StudioKAT/GateSequencer/README.md

# Gate Sequencer
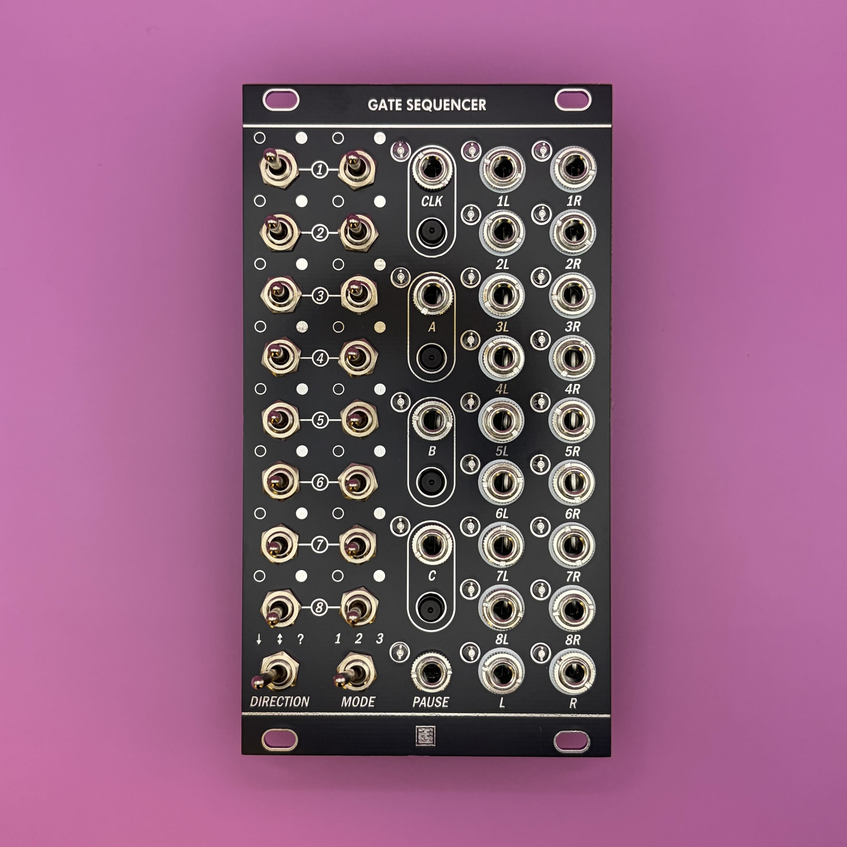
[picture p1: v2.0/Images/GateSequencer_v2.0_Front.jpg]
Gate Sequencer Front


## 概要 / Overview

**Gate Sequencer** は、トグルスイッチ式の多機能ゲートシーケンサーです。   
・独立した2つのクロックで動く **8 Stepシーケンサー x2**  
・パフォーマンス機能を備えた **16 Stepシーケンサー**  
・可変長・経路変更可能な **シフトレジスタ (Turing Machine)**  
の3つの機能を備え、スイッチ一つで切り替えて使用できます。

**Gate Sequencer** is a multi-functional gate sequencer equipped with toggle switches. It features three distinct functions that can be switched via a single mode switch:
* **8-Step Sequencer x2** running on independent clocks.
* **16-Step Sequencer** with performance features.
* **Shift Register (Turing Machine)** with variable length and routing capabilities. 

## 仕様 / Spec
- Format: Eurorack
- Function: Gate Sequencer
- Current needs: +12V: 50mA, -12V: 0mA
- Width: 14 HP
- Depth: 25mm (including power connector)

## 販売 / Sales

StudioKATオフィシャルショップで販売しています。(日本国内限定)  
https://www.studiokat.jp/items/164466252

## ライセンス / License

この作品は [Creative Commons 表示 - 継承 4.0 国際 (CC BY-SA 4.0)](https://creativecommons.org/licenses/by-sa/4.0/deed.ja) の下でライセンスされています。  
This work is licensed under the [Creative Commons Attribution-ShareAlike 4.0 International License](https://creativecommons.org/licenses/by-sa/4.0/).

## クレジット / Credits

- Designed by : StudioKAT
- Website : https://www.studiokat.jp/
- GitHub : https://github.com/StudioKAT
- X(Twitter) : https://x.com/StudioKAT_synth
- Instagram : https://www.instagram.com/studiokat_modular/

## 更新履歴 / Changelog

- `2026-10-29`：v2.0 リリース
- `2025-11-22`：v1.0 リリース
