StudioKAT/GateSequencer/Images/GateSequencer_v1.0_Back.jpg

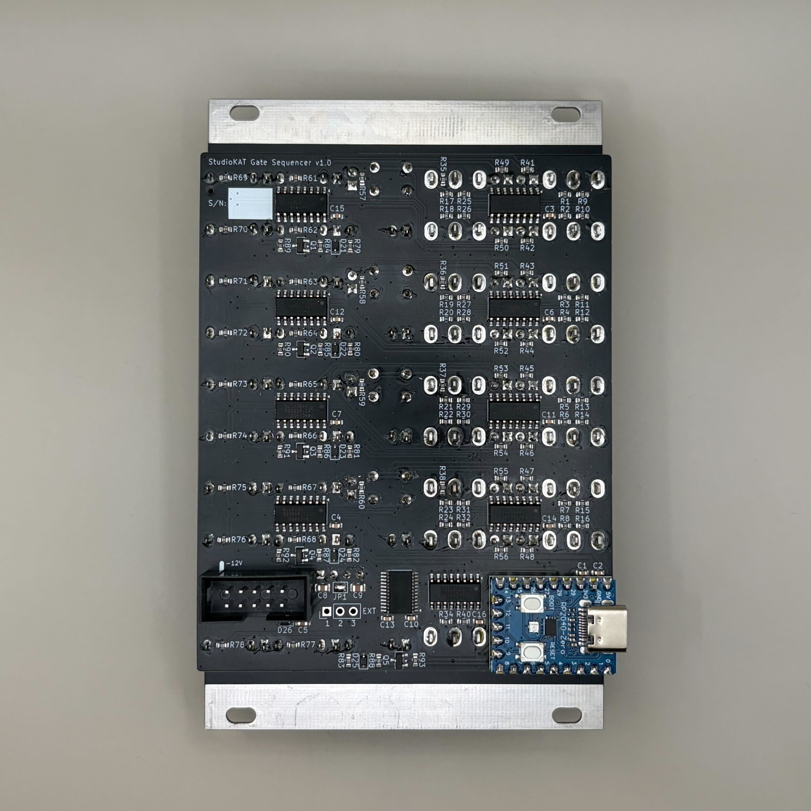
Images/GateSequencer_v1.0_Back.jpg
