StudioKAT/GateSequencer/v2.0/Images/GateSequencer_v2.0_Back.jpg

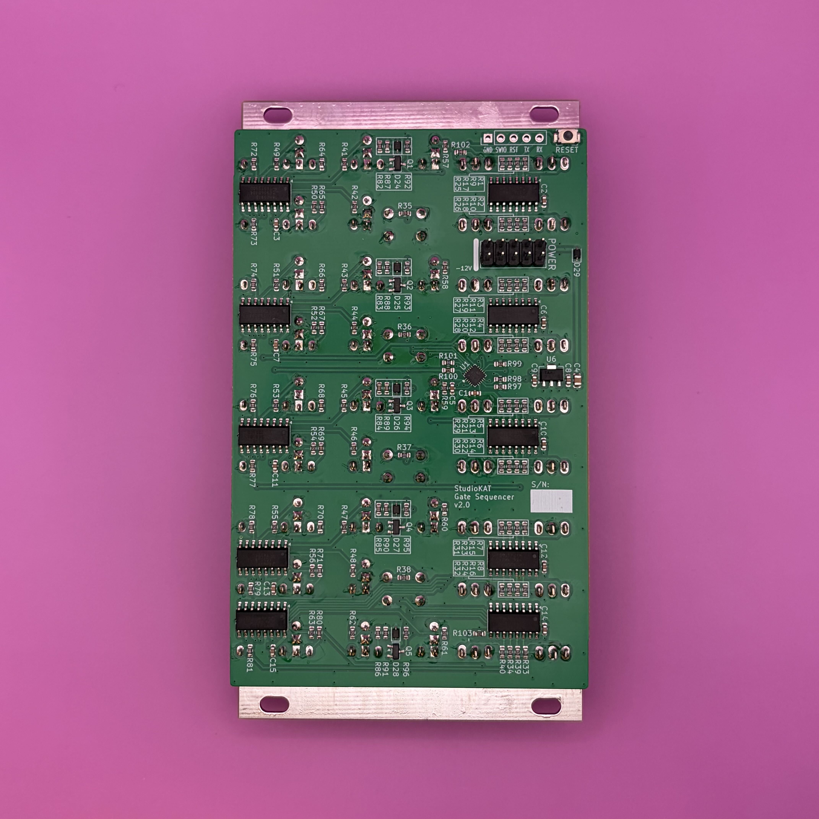
v2.0/Images/GateSequencer_v2.0_Back.jpg
