StudioKAT/GateSequencer/v2.0/Hardware/Gerber_for_JLCPCB/Main/bom.csv

Designator | Footprint | Quantity | Value | LCSC Part #
C1, C10, C11, C12, C13, C14, C15, C2, C3, C5, C6, C7, C9 | 0603 | 13 | 100nF | C14663
C4 | 0805 | 1 | 22uF | C45783
C8 | 0603 | 1 | 330nF | C1615
D1, D10, D11, D12, D13, D14, D15, D16, D17, D18, D19, D2, D20, D21, D22, D23, D3, D4, D5, D6, D7, D8, D9 | LED_D3.0mm_2hp | 23 | LED
D24, D25, D26, D27, D28 | D_SOD-323 | 5 | 1N4148WS | C2128
D29 | D_SOD-323 | 1 | 1N5819WS | C64886
J1 | AudioJack_PJ301M-12 | 1 | OUT_1
J10 | AudioJack_PJ301M-12 | 1 | OUT_10
J11 | AudioJack_PJ301M-12 | 1 | OUT_11
J12 | AudioJack_PJ301M-12 | 1 | OUT_12
J13 | AudioJack_PJ301M-12 | 1 | OUT_13
J14 | AudioJack_PJ301M-12 | 1 | OUT_14
J15 | AudioJack_PJ301M-12 | 1 | OUT_15
J16 | AudioJack_PJ301M-12 | 1 | OUT_16
J17 | AudioJack_PJ301M-12 | 1 | OUT_A
J18 | AudioJack_PJ301M-12 | 1 | OUT_B
J19 | AudioJack_PJ301M-12 | 1 | CLK
J2 | AudioJack_PJ301M-12 | 1 | OUT_2
J20 | AudioJack_PJ301M-12 | 1 | IN_A
J21 | AudioJack_PJ301M-12 | 1 | IN_B
J22 | AudioJack_PJ301M-12 | 1 | IN_C
J23 | AudioJack_PJ301M-12 | 1 | PAUSE
J24 | PinHeader_2x05_2.54mm_Europower | 1 | POWER
J25 | PinHeader_1x05_P2.54mm_Vertical | 1 | Conn_01x05_Pin
J3 | AudioJack_PJ301M-12 | 1 | OUT_3
J4 | AudioJack_PJ301M-12 | 1 | OUT_4
J5 | AudioJack_PJ301M-12 | 1 | OUT_5
J6 | AudioJack_PJ301M-12 | 1 | OUT_6
J7 | AudioJack_PJ301M-12 | 1 | OUT_7
J8 | AudioJack_PJ301M-12 | 1 | OUT_8
J9 | AudioJack_PJ301M-12 | 1 | OUT_9
Q1, Q2, Q3, Q4, Q5 | SOT-23 | 5 | MMBT3904 | C20526
R1, R10, R11, R12, R13, R14, R15, R16, R17, R18, R19, R2, R20, R21, R22, R23, R24, R25, R26, R27, R28, R29, R3, R30, R31, R32, R33, R34, R35, R36, R37, R38, R39, R4, R40, R5, R6, R7, R8, R9, R92, R93, R94, R95, R96 | 0603 | 45 | 12K | C22790
R100, R103, R97, R98, R99 | 0603 | 5 | 47 | C23182
R101, R102, R64, R65, R66, R67, R68, R69, R70, R71, R72, R73, R74, R75, R76, R77, R78, R79, R80, R81 | 0603 | 20 | 1k | C21190
R41, R42, R43, R44, R45, R46, R47, R48, R49, R50, R51, R52, R53, R54, R55, R56, R57, R58, R59, R60, R61, R62, R63 | 0603 | 23 | 2.4K | C22940
R82, R83, R84, R85, R86, R87, R88, R89, R90, R91 | 0603 | 10 | 100K | C25803
SW1, SW10, SW11, SW12, SW13, SW14, SW15, SW16, SW17, SW18, SW2, SW3, SW4, SW5, SW6, SW7, SW8, SW9 | ToggleSwitch_SMTS-103-2A1 | 18 | SMTS-103-2A1
SW19, SW20, SW21, SW22 | SW_PUSH_6mm_H13mm | 4 | SW_Push
SW23 | SW_Push_TS-1088-AR02016 | 1 | RESET | C720477
U1 | QFN-20-1EP_3x3mm_P0.4mm_EP1.65x1.65mm | 1 | CH32V003F4U6 | C5299908
U10, U12, U3, U5, U8 | SOIC-16_3.9x9.9mm_P1.27mm | 5 | 74HC595D,118 | C5947
U11, U2, U4, U7, U9 | SOIC-16_3.9x9.9mm_P1.27mm | 5 | 74HC165D,653 | C5613
U6 | SOT-89-3 | 1 | 78L05G-AB3-R | C71136
