StudioKAT/GateSequencer/v2.0/Hardware/Schematics/GateSequencer_scheatics_v2.0.pdf

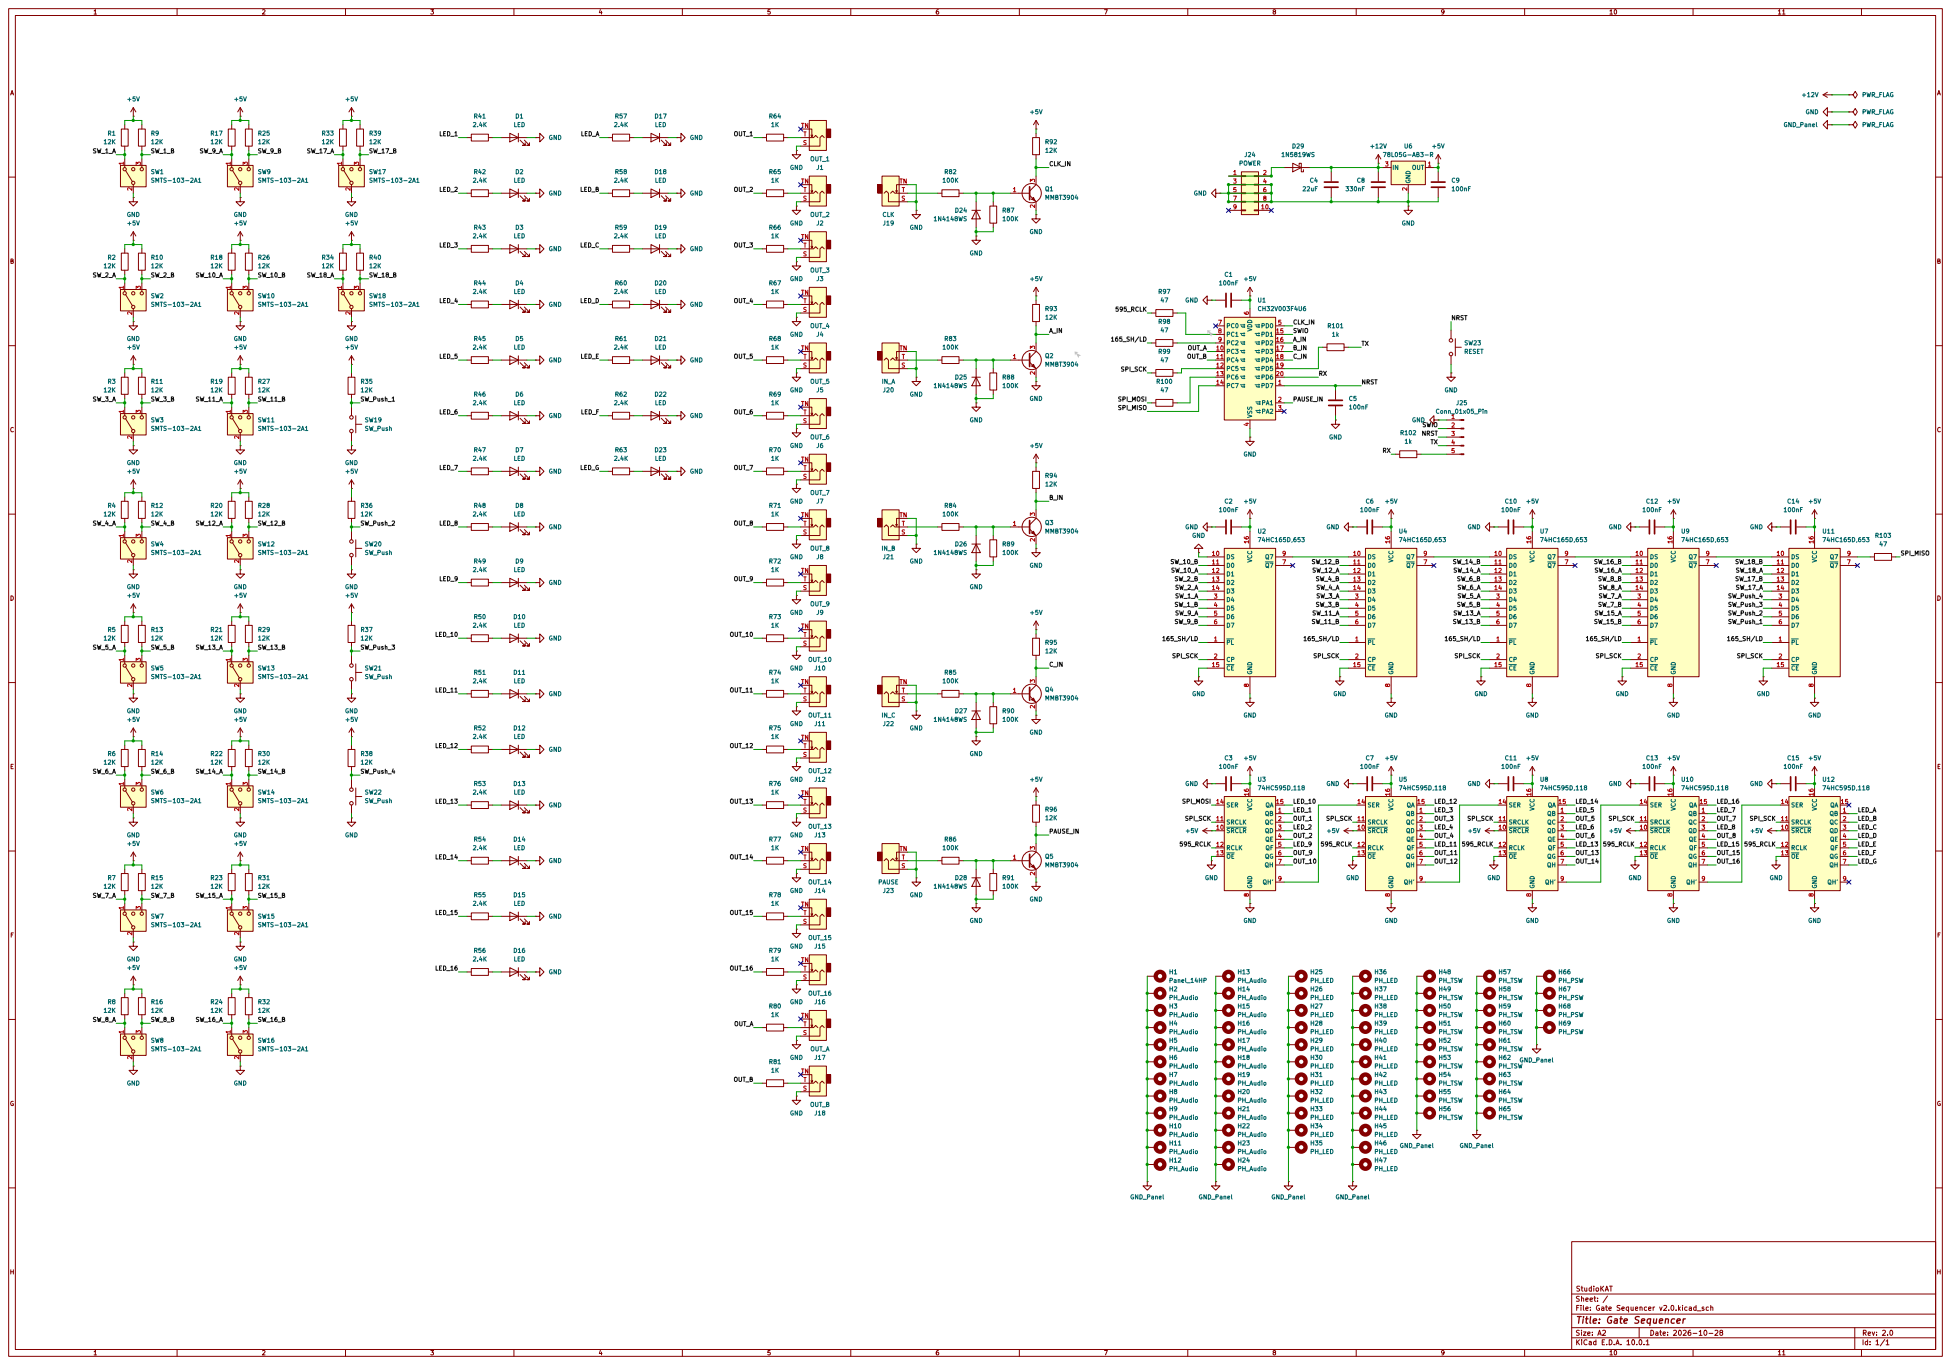
[picture p7: page 1]
