StudioKAT/GateSequencer/v1.0/Hardware/Schematics/GateSequencer_schematics_v1.0.pdf

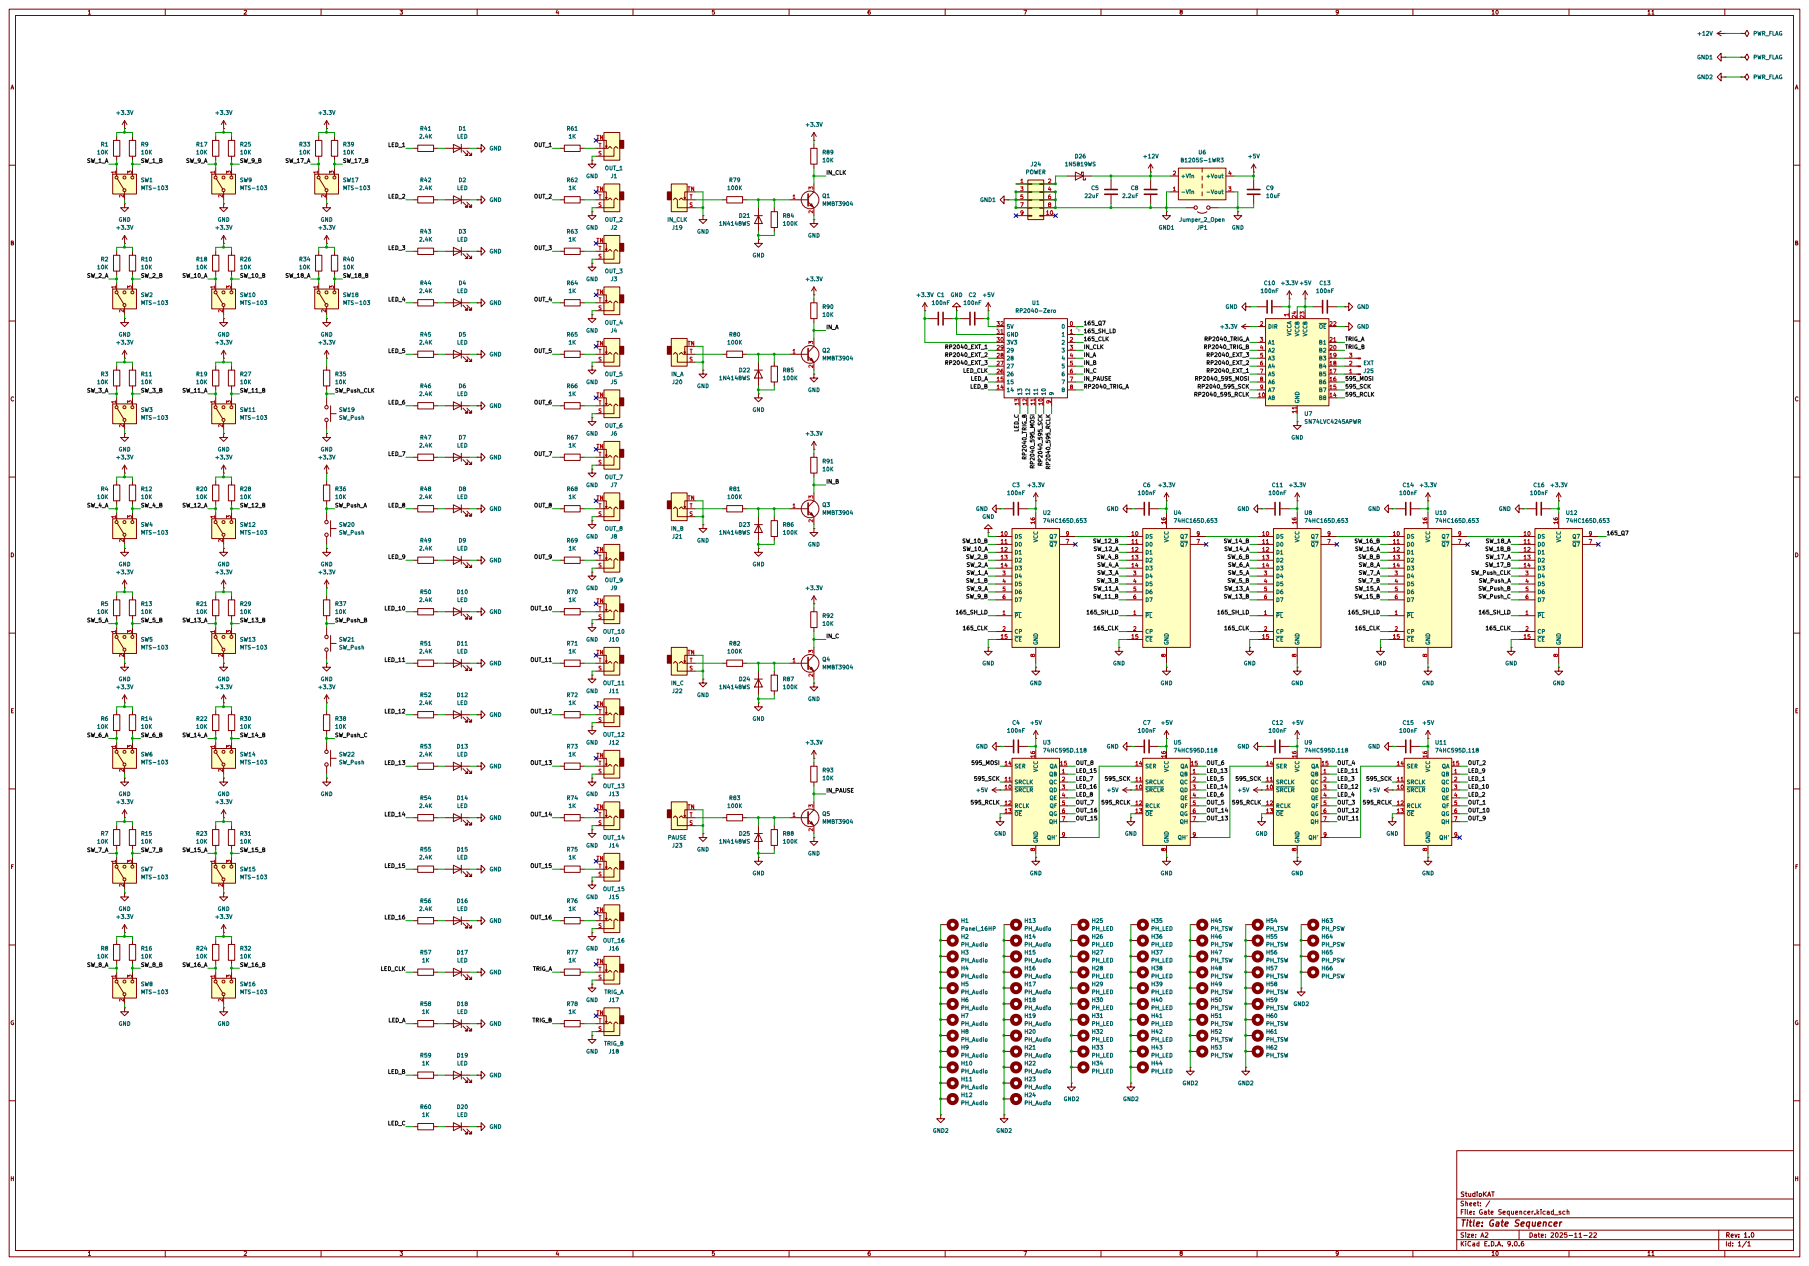
[picture p8: page 1]
