StudioKAT/GateSequencer/v1.0/Hardware/KiCAD/Gate Sequencer/Gate Sequencer.kicad_pcb

## KiCad design v1.0/Hardware/KiCAD/Gate Sequencer/Gate Sequencer.kicad_pcb (2026-10-30, an earlier design)

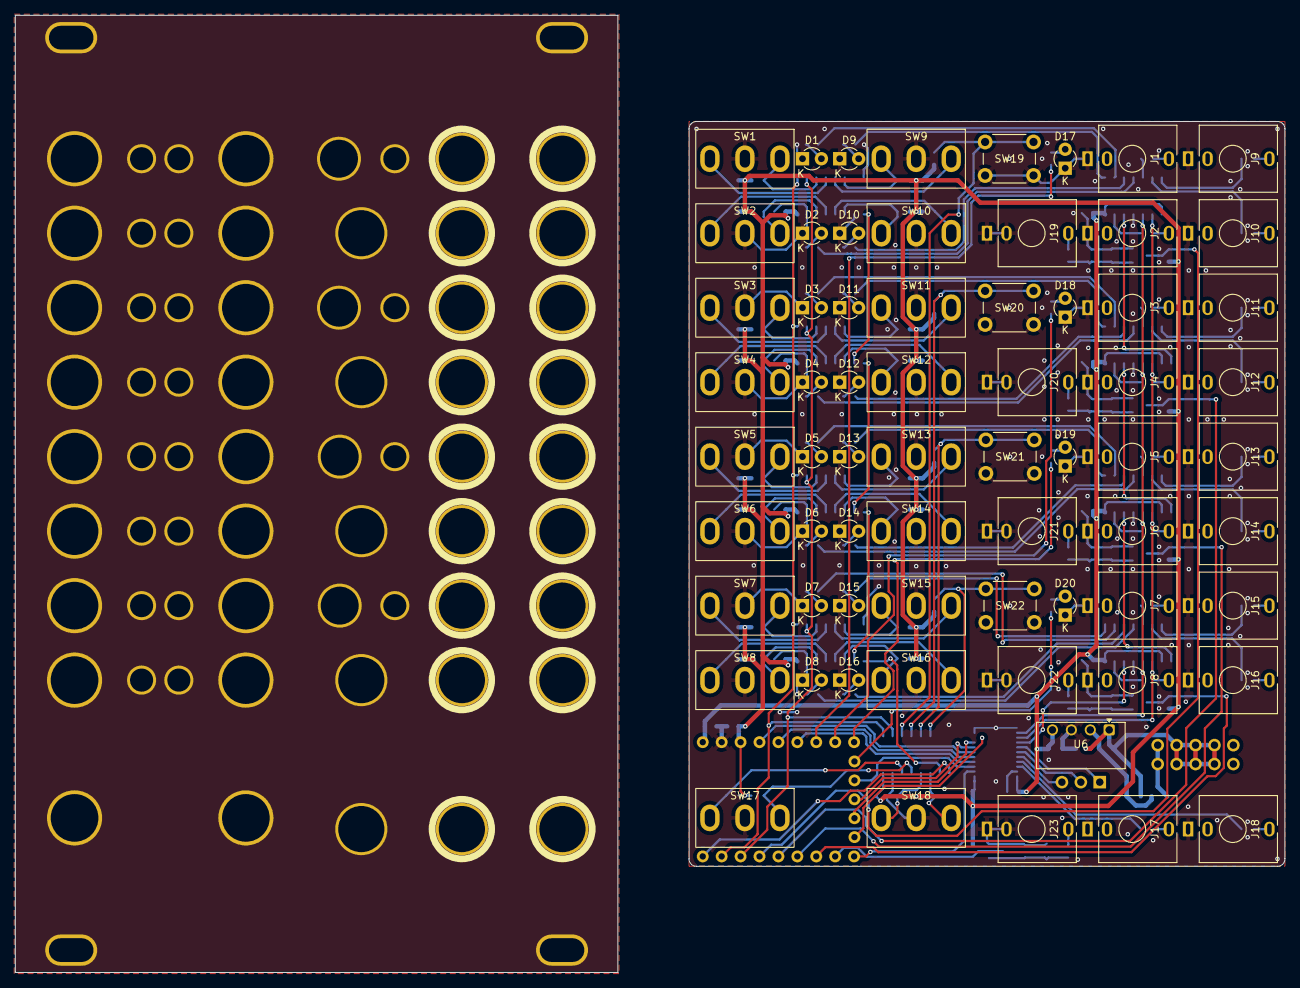
[picture p13: board Gate Sequencer.kicad_pcb from above]

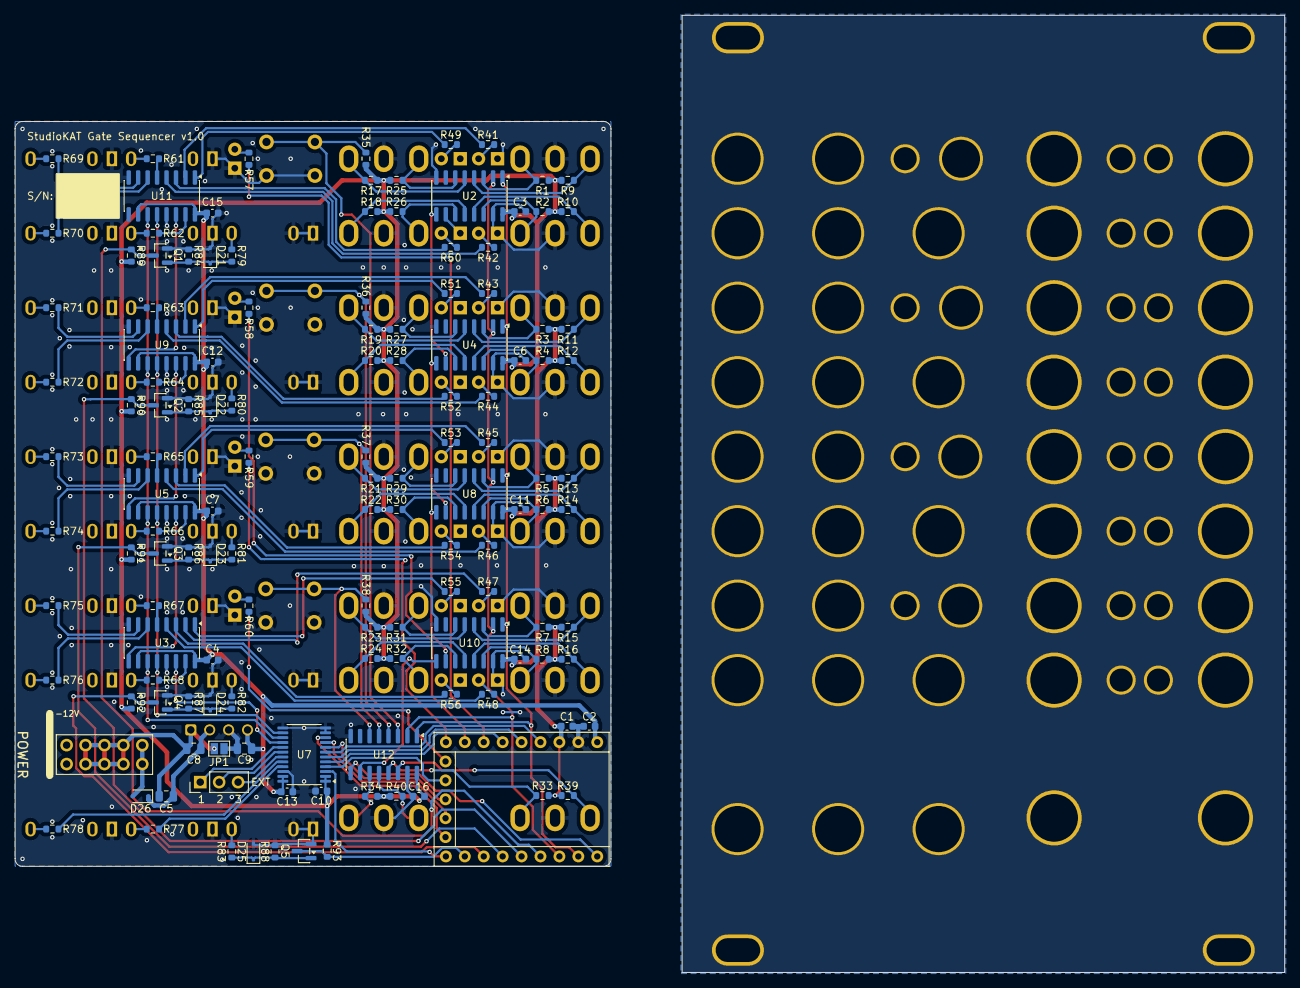
[picture p14: board Gate Sequencer.kicad_pcb from below]

Board: 2 copper layers, 170.4 x 128.5 mm, 266 parts (134 on the bottom side), 162 nets.

Parts:
C1, C2, C3, C4, C6, C7, C10, C11, C12, C13, C14, C15, C16: 100nF; C_0603_1608Metric
C5: 22uF; C_0805_2012Metric
C8: 2.2uF; C_0805_2012Metric
C9: 10uF; C_0805_2012Metric
D1, D2, D3, D4, D5, D6, D7, D8, D9, D10, D11, D12, D13, D14, D15, D16, D17, D18, D19, D20: LED; LED_D3.0mm_2hp
D21, D22, D23, D24, D25: 1N4148WS; D_SOD-323
D26: 1N5819WS; D_SOD-323
H1: Panel_16HP
H2, H3, H4, H5, H6, H7, H8, H9, H10, H11, H12, H13, H14, H15, H16, H17, H18, H19, H20, H21, H22, H23, H24: PH_Audio; PH_AudioJack_3.5mm_Pad
H25, H26, H27, H28, H29, H30, H31, H32, H33, H34, H35, H36, H37, H38, H39, H40, H41, H42, H43, H44: PH_LED; PH_LED_3.0mm_Pad
H45, H46, H47, H48, H49, H50, H51, H52, H53, H54, H55, H56, H57, H58, H59, H60, H61, H62: PH_TSW; PH_ToggleSwitch_6.4mm_Pad
H63, H64, H65, H66: PH_PSW; PH_ToggleSwitch_5.1mm_Pad
J1: OUT_1; AudioJack_PJ301M-12
J2: OUT_2; AudioJack_PJ301M-12
J3: OUT_3; AudioJack_PJ301M-12
J4: OUT_4; AudioJack_PJ301M-12
J5: OUT_5; AudioJack_PJ301M-12
J6: OUT_6; AudioJack_PJ301M-12
J7: OUT_7; AudioJack_PJ301M-12
J8: OUT_8; AudioJack_PJ301M-12
J9: OUT_9; AudioJack_PJ301M-12
J10: OUT_10; AudioJack_PJ301M-12
J11: OUT_11; AudioJack_PJ301M-12
J12: OUT_12; AudioJack_PJ301M-12
J13: OUT_13; AudioJack_PJ301M-12
J14: OUT_14; AudioJack_PJ301M-12
J15: OUT_15; AudioJack_PJ301M-12
J16: OUT_16; AudioJack_PJ301M-12
J17: OUT_A; AudioJack_PJ301M-12
J18: OUT_B; AudioJack_PJ301M-12
J19: CLK_A; AudioJack_PJ301M-12
J20: CLK_B; AudioJack_PJ301M-12
J21: RST_A; AudioJack_PJ301M-12
J22: RST_B; AudioJack_PJ301M-12
J23: PAUSE; AudioJack_PJ301M-12
J24: POWER; BoxHeader_2x05_2.54mm_Europower
J25: EXT; PinHeader_1x03_P2.54mm_Vertical
JP1: Jumper_2_Open; SolderJumper-2_P1.3mm_Open_Pad1.0x1.5mm
Q1, Q2, Q3, Q4, Q5: MMBT3904; SOT-23
R1, R2, R3, R4, R5, R6, R7, R8, R9, R10, R11, R12, R13, R14, R15, R16, R17, R18, R19, R20, R21, R22, R23, R24, R25, R26, R27, R28, R29, R30, R31, R32, R33, R34, R35, R36, R37, R38, R39, R40, R89, R90, R91, R92, R93: 10K; R_0603_1608Metric
R41, R42, R43, R44, R45, R46, R47, R48, R49, R50, R51, R52, R53, R54, R55, R56: 2.4K; R_0603_1608Metric
R57, R58, R59, R60, R61, R62, R63, R64, R65, R66, R67, R68, R69, R70, R71, R72, R73, R74, R75, R76, R77, R78: 1K; R_0603_1608Metric
R79, R80, R81, R82, R83, R84, R85, R86, R87, R88: 100K; R_0603_1608Metric
SW1, SW2, SW3, SW4, SW5, SW6, SW7, SW8, SW9, SW10, SW11, SW12, SW13, SW14, SW15, SW16, SW17, SW18: MTS-103; SW_MTS-102_103
SW19, SW20, SW21, SW22: SW_Push; SW_PUSH_6mm_H13mm
U1: RP2040-Zero
U2, U4, U8, U10, U12: 74HC165D,653; SOIC-16_3.9x9.9mm_P1.27mm
U3, U5, U9, U11: 74HC595D,118; SOIC-16_3.9x9.9mm_P1.27mm
U6: B1205S-1WR3; Converter_DCDC_TRACO_TEA1-xxxx_THT
U7: SN74LVC4245APWR; TSSOP-24_4.4x7.8mm_P0.65mm

Connections:
+3.3V: C1.1, C3.2, C6.2, C10.2, C11.2, C14.2, C16.2, R1.1, R2.1, R3.1, R4.1, R5.1, R6.1, R7.1, R8.1, R9.1, R10.1, R11.1, R12.1, R13.1, R14.1, R15.1, R16.1, R17.1, R18.1, R19.1, R20.1, R21.1, R22.1, R23.1, R24.1, R25.1, R26.1, R27.1, R28.1, R29.1, R30.1, R31.1, R32.1, R33.1, R34.1, R35.1, R36.1, R37.1, R38.1, R39.1, R40.1, R89.1, R90.1, R91.1, R92.1, R93.1, U1.30 (3V3), U2.16 (VCC), U4.16 (VCC), U7.1 (VCCA), U7.2 (DIR), U8.16 (VCC), U10.16 (VCC), U12.16 (VCC)
+5V: C2.2, C4.2, C7.2, C9.1, C12.2, C13.1, C15.2, U1.32 (5V), U3.10 (~SRCLR), U3.16 (VCC), U5.10 (~SRCLR), U5.16 (VCC), U6.4 (+Vout), U7.23 (VCCB), U7.24 (VCCB), U9.10 (~SRCLR), U9.16 (VCC), U11.10 (~SRCLR), U11.16 (VCC)
+12V: C5.1, C8.1, D26.1 (K), U6.2 (+Vin)
/CLK_A: Q1.3 (C), R89.2, U1.3
/CLK_B: Q2.3 (C), R90.2, U1.4
/Clock: U1.2, U2.2 (CP), U4.2 (CP), U8.2 (CP), U10.2 (CP), U12.2 (CP)
/LED_1: R41.1, U11.2 (QC)
/LED_2: R42.1, U11.4 (QE)
/LED_3: R43.1, U9.2 (QC)
/LED_4: R44.1, U9.4 (QE)
/LED_5: R45.1, U5.2 (QC)
/LED_6: R46.1, U5.4 (QE)
/LED_7: R47.1, U3.2 (QC)
/LED_8: R48.1, U3.4 (QE)
/LED_9: R49.1, U11.1 (QB)
/LED_10: R50.1, U11.3 (QD)
/LED_11: R51.1, U9.1 (QB)
/LED_12: R52.1, U9.3 (QD)
/LED_13: R53.1, U5.1 (QB)
/LED_14: R54.1, U5.3 (QD)
/LED_15: R55.1, U3.1 (QB)
/LED_16: R56.1, U3.3 (QD)
/LED_A: R57.1, U1.26
/LED_B: R58.1, U1.15
/LED_C: R59.1, U1.14
/LED_D: R60.1, U1.13
/OUT_1: R61.1, U11.5 (QF)
/OUT_2: R62.1, U11.15 (QA)
/OUT_3: R63.1, U9.5 (QF)
/OUT_4: R64.1, U9.15 (QA)
/OUT_5: R65.1, U5.5 (QF)
/OUT_6: R66.1, U5.15 (QA)
/OUT_7: R67.1, U3.5 (QF)
/OUT_8: R68.1, U3.15 (QA)
/OUT_9: R69.1, U11.7 (QH)
/OUT_10: R70.1, U11.6 (QG)
/OUT_11: R71.1, U9.7 (QH)
/OUT_12: R72.1, U9.6 (QG)
/OUT_13: R73.1, U5.7 (QH)
/OUT_14: R74.1, U5.6 (QG)
/OUT_15: R75.1, U3.7 (QH)
/OUT_16: R76.1, U3.6 (QG)
/OUT_A: R77.1, U7.21 (B1)
/OUT_B: R78.1, U7.20 (B2)
/PAUSE: Q5.3 (C), R93.2, U1.7
/RCLK: U3.12 (RCLK), U5.12 (RCLK), U7.14 (B8), U9.12 (RCLK), U11.12 (RCLK)
/RP2040_EXT_1: U1.29, U7.7 (A5)
/RP2040_EXT_2: U1.28, U7.6 (A4)
/RP2040_EXT_3: U1.27, U7.5 (A3)
/RP2040_OUT_A: U1.8, U7.3 (A1)
/RP2040_OUT_B: U1.12, U7.4 (A2)
/RP2040_RCLK: U1.9, U7.10 (A8)
/RP2040_SER: U1.11, U7.8 (A6)
/RP2040_SRCLK: U1.10, U7.9 (A7)
/RST_A: Q3.3 (C), R91.2, U1.5
/RST_B: Q4.3 (C), R92.2, U1.6
/SER: U3.14 (SER), U7.16 (B6)
/SRCLK: U3.11 (SRCLK), U5.11 (SRCLK), U7.15 (B7), U9.11 (SRCLK), U11.11 (SRCLK)
/SR_Read: U1.0, U12.9 (Q7)
/SW_1_A: R1.2, SW1.1, U2.3 (D4)
/SW_1_B: R9.2, SW1.3 (4), U2.4 (D5)
/SW_2_A: R2.2, SW2.1, U2.14 (D3)
/SW_2_B: R10.2, SW2.3 (4), U2.13 (D2)
/SW_3_A: R3.2, SW3.1, U4.3 (D4)
/SW_3_B: R11.2, SW3.3 (4), U4.4 (D5)
/SW_4_A: R4.2, SW4.1, U4.14 (D3)
/SW_4_B: R12.2, SW4.3 (4), U4.13 (D2)
/SW_5_A: R5.2, SW5.1, U8.3 (D4)
/SW_5_B: R13.2, SW5.3 (4), U8.4 (D5)
/SW_6_A: R6.2, SW6.1, U8.14 (D3)
/SW_6_B: R14.2, SW6.3 (4), U8.13 (D2)
/SW_7_A: R7.2, SW7.1, U10.3 (D4)
/SW_7_B: R15.2, SW7.3 (4), U10.4 (D5)
/SW_8_A: R8.2, SW8.1, U10.14 (D3)
/SW_8_B: R16.2, SW8.3 (4), U10.13 (D2)
/SW_9_A: R17.2, SW9.1, U2.5 (D6)
/SW_9_B: R25.2, SW9.3 (4), U2.6 (D7)
/SW_10_A: R18.2, SW10.1, U2.12 (D1)
/SW_10_B: R26.2, SW10.3 (4), U2.11 (D0)
/SW_11_A: R19.2, SW11.1, U4.5 (D6)
/SW_11_B: R27.2, SW11.3 (4), U4.6 (D7)
/SW_12_A: R20.2, SW12.1, U4.12 (D1)
/SW_12_B: R28.2, SW12.3 (4), U4.11 (D0)
/SW_13_A: R21.2, SW13.1, U8.5 (D6)
/SW_13_B: R29.2, SW13.3 (4), U8.6 (D7)
/SW_14_A: R22.2, SW14.1, U8.12 (D1)
/SW_14_B: R30.2, SW14.3 (4), U8.11 (D0)
/SW_15_A: R23.2, SW15.1, U10.5 (D6)
/SW_15_B: R31.2, SW15.3 (4), U10.6 (D7)
/SW_16_A: R24.2, SW16.1, U10.12 (D1)
/SW_16_B: R32.2, SW16.3 (4), U10.11 (D0)
/SW_17_A: R33.2, SW17.1, U12.13 (D2)
/SW_17_B: R39.2, SW17.3 (4), U12.14 (D3)
/SW_18_A: R34.2, SW18.1, U12.11 (D0)
/SW_18_B: R40.2, SW18.3 (4), U12.12 (D1)
/SW_Push_1: R35.2, SW19.1, U12.3 (D4)
/SW_Push_2: R36.2, SW20.1, U12.4 (D5)
/SW_Push_3: R37.2, SW21.1, U12.5 (D6)
/SW_Push_4: R38.2, SW22.1, U12.6 (D7)
/Shift/nLoad: U1.1, U2.1 (~PL), U4.1 (~PL), U8.1 (~PL), U10.1 (~PL), U12.1 (~PL)
GND: C1.2, C2.1, C3.1, C4.1, C6.1, C7.1, C9.2, C10.1, C11.1, C12.1, C13.2, C14.1, C15.1, C16.1, D1.1 (K), D2.1 (K), D3.1 (K), D4.1 (K), D5.1 (K), D6.1 (K), D7.1 (K), D8.1 (K), D9.1 (K), D10.1 (K), D11.1 (K), D12.1 (K), D13.1 (K), D14.1 (K), D15.1 (K), D16.1 (K), D17.1 (K), D18.1 (K), D19.1 (K), D20.1 (K), D21.2 (A), D22.2 (A), D23.2 (A), D24.2 (A), D25.2 (A), J1.S, J2.S, J3.S, J4.S, J5.S, J6.S, J7.S, J8.S, J9.S, J10.S, J11.S, J12.S, J13.S, J14.S, J15.S, J16.S, J17.S, J18.S, J19.S, J19.TN, J20.S, J20.TN, J21.S, J21.TN, J22.S, J22.TN, J23.S, J23.TN, JP1.2 (B), Q1.2 (E), Q2.2 (E), Q3.2 (E), Q4.2 (E), Q5.2 (E), R84.2, R85.2, R86.2, R87.2, R88.2, SW1.2 (3), SW2.2 (3), SW3.2 (3), SW4.2 (3), SW5.2 (3), SW6.2 (3), SW7.2 (3), SW8.2 (3), SW9.2 (3), SW10.2 (3), SW11.2 (3), SW12.2 (3), SW13.2 (3), SW14.2 (3), SW15.2 (3), SW16.2 (3), SW17.2 (3), SW18.2 (3), SW19.2, SW20.2, SW21.2, SW22.2, U1.31 (GND), U2.8 (GND), U2.10 (DS), U2.15 (~CE), U3.8 (GND), U3.13 (~OE), U4.8 (GND), U4.15 (~CE), U5.8 (GND), U5.13 (~OE), U6.3 (-Vout), U7.11 (GND), U7.12 (GND), U7.13 (GND), U7.22 (~OE), U8.8 (GND), U8.15 (~CE), U9.8 (GND), U9.13 (~OE), U10.8 (GND), U10.15 (~CE), U11.8 (GND), U11.13 (~OE), U12.8 (GND), U12.15 (~CE)
GND1: C5.2, C8.2, J24.3, J24.4, J24.5, J24.6, J24.7, J24.8, JP1.1 (A), U6.1 (-Vin)
GND2: H1.1, H2.1, H3.1, H4.1, H5.1, H6.1, H7.1, H8.1, H9.1, H10.1, H11.1, H12.1, H13.1, H14.1, H15.1, H16.1, H17.1, H18.1, H19.1, H20.1, H21.1, H22.1, H23.1, H24.1, H25.1, H26.1, H27.1, H28.1, H29.1, H30.1, H31.1, H32.1, H33.1, H34.1, H35.1, H36.1, H37.1, H38.1, H39.1, H40.1, H41.1, H42.1, H43.1, H44.1, H45.1, H46.1, H47.1, H48.1, H49.1, H50.1, H51.1, H52.1, H53.1, H54.1, H55.1, H56.1, H57.1, H58.1, H59.1, H60.1, H61.1, H62.1, H63.1, H64.1, H65.1, H66.1
unnamed: D1.2 (A), R41.2
unnamed: D2.2 (A), R42.2
unnamed: D3.2 (A), R43.2
unnamed: D4.2 (A), R44.2
unnamed: D5.2 (A), R45.2
unnamed: D6.2 (A), R46.2
unnamed: D7.2 (A), R47.2
unnamed: D8.2 (A), R48.2
unnamed: D9.2 (A), R49.2
unnamed: D10.2 (A), R50.2
unnamed: D11.2 (A), R51.2
unnamed: D12.2 (A), R52.2
unnamed: D13.2 (A), R53.2
unnamed: D14.2 (A), R54.2
unnamed: D15.2 (A), R55.2
unnamed: D16.2 (A), R56.2
unnamed: D17.2 (A), R57.2
unnamed: D18.2 (A), R58.2
unnamed: D19.2 (A), R59.2
unnamed: D20.2 (A), R60.2
unnamed: D21.1 (K), Q1.1 (B), R79.2, R84.1
unnamed: D22.1 (K), Q2.1 (B), R80.2, R85.1
unnamed: D23.1 (K), Q3.1 (B), R81.2, R86.1
unnamed: D24.1 (K), Q4.1 (B), R82.2, R87.1
unnamed: D25.1 (K), Q5.1 (B), R83.2, R88.1
unnamed: D26.2 (A), J24.1, J24.2
unnamed: J1.T, R61.2
unnamed: J2.T, R62.2
unnamed: J3.T, R63.2
unnamed: J4.T, R64.2
unnamed: J5.T, R65.2
unnamed: J6.T, R66.2
unnamed: J7.T, R67.2
unnamed: J8.T, R68.2
unnamed: J9.T, R69.2
unnamed: J10.T, R70.2
unnamed: J11.T, R71.2
unnamed: J12.T, R72.2
unnamed: J13.T, R73.2
unnamed: J14.T, R74.2
unnamed: J15.T, R75.2
unnamed: J16.T, R76.2
unnamed: J17.T, R77.2
unnamed: J18.T, R78.2
unnamed: J19.T, R79.1
unnamed: J20.T, R80.1
unnamed: J21.T, R81.1
unnamed: J22.T, R82.1
unnamed: J23.T, R83.1
unnamed: J25.1, U7.17 (B5)
unnamed: J25.2, U7.18 (B4)
unnamed: J25.3, U7.19 (B3)
unnamed: U2.9 (Q7), U4.10 (DS)
unnamed: U3.9 (QH'), U5.14 (SER)
unnamed: U4.9 (Q7), U8.10 (DS)
unnamed: U5.9 (QH'), U9.14 (SER)
unnamed: U8.9 (Q7), U10.10 (DS)
unnamed: U10.9 (Q7), U12.10 (DS)
unnamed: U9.9 (QH'), U11.14 (SER)
