StudioKAT/GateSequencer/(commit log)

2025-11-27 Firmware v1 プロジェクト名変更
2025-11-29 ディレクトリ構造変更
2026-10-30 v2.0リリース
2026-10-30 .gitignore KiCADバックアップが入らないように更新
2026-10-30 Stop tracking ignored KiCad backup files
2026-10-30 マニュアルの書き込みフォルダ名修正
2026-10-30 フォルダ名修正
2026-10-30 マニュアル改行修正
